gralco/PLS8-M.2-Key-B-3042/PLS8_M2_Key_B_3042.kicad_pcb

## KiCad design PLS8_M2_Key_B_3042.kicad_pcb (2022-02-09)

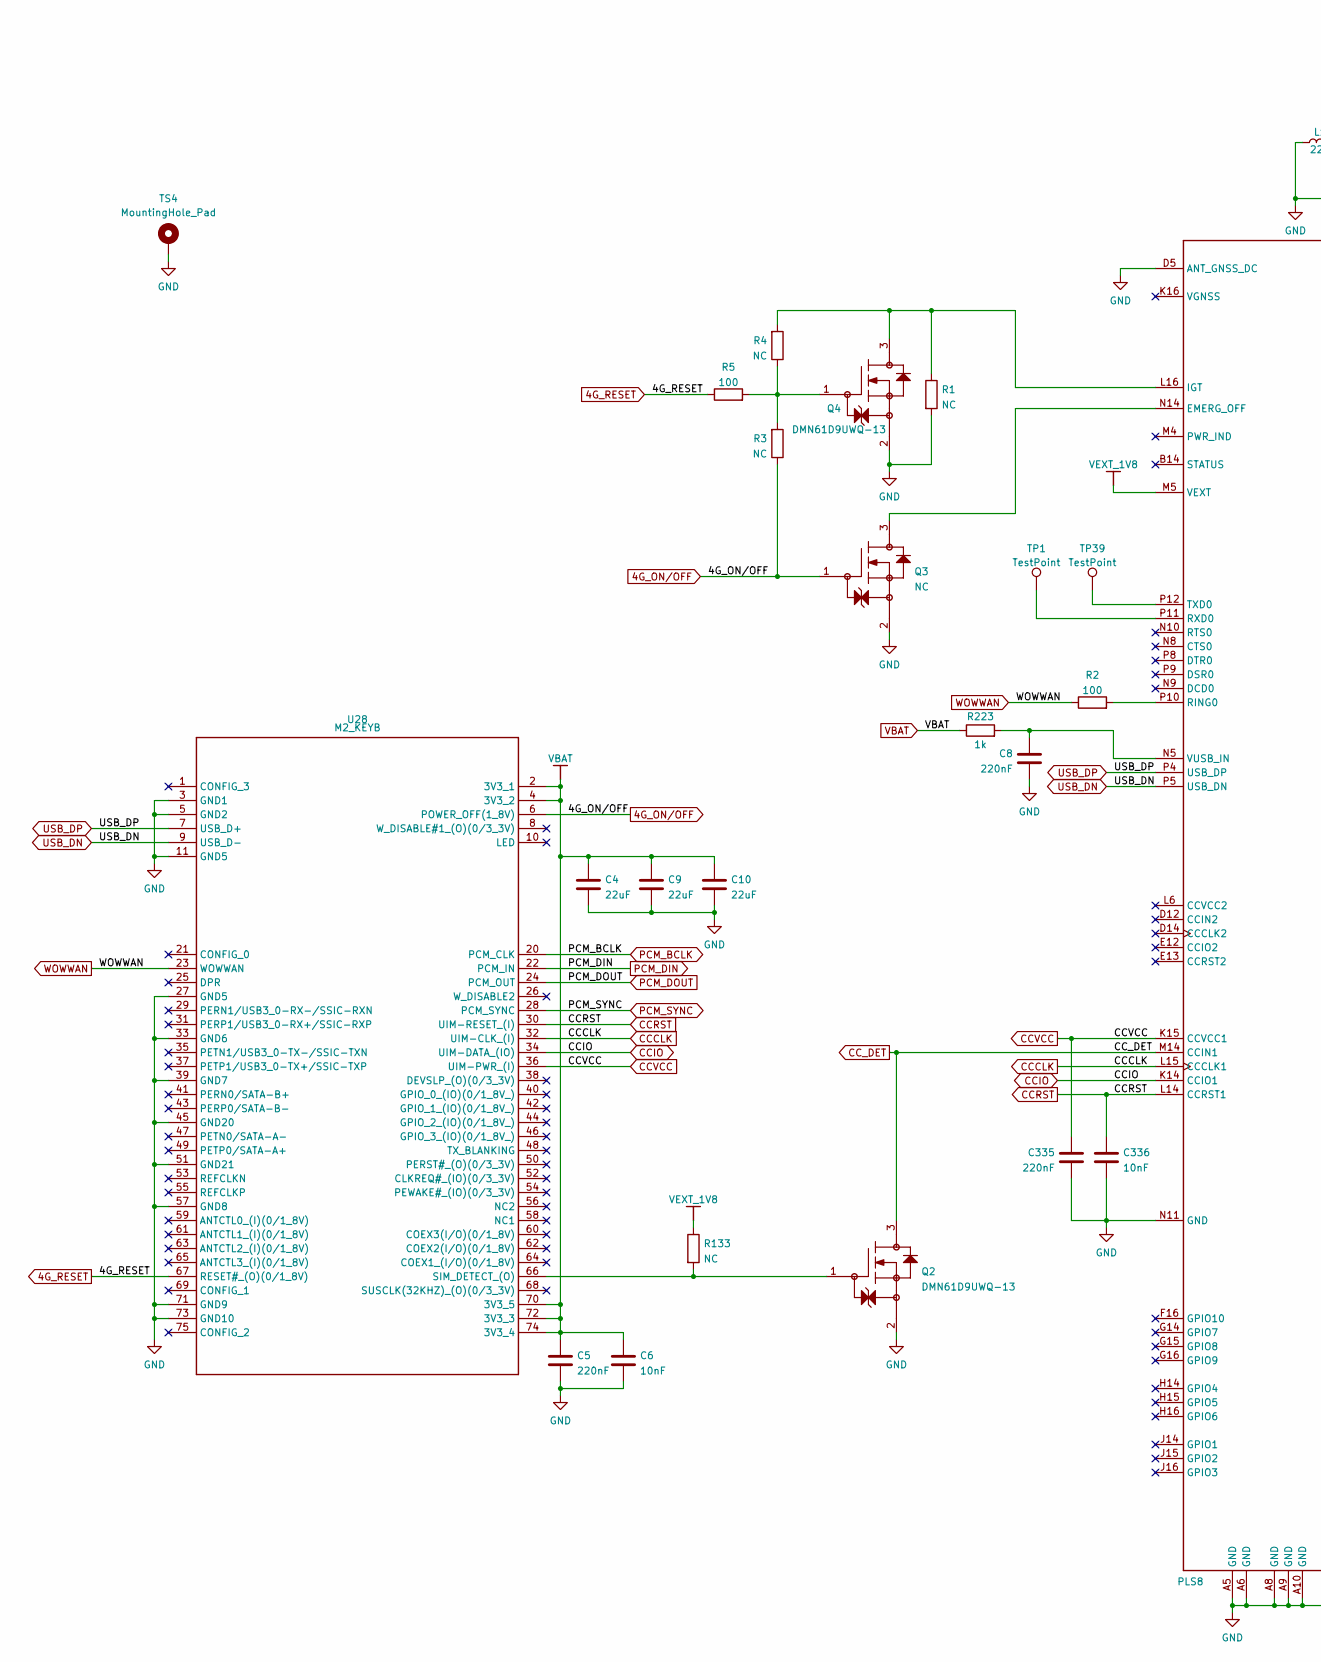
[picture p1: schematic PLS8_M2_Key_B_3042.kicad_sch, PLS8 M.2 Key B 3042 WWAN Module, part in row 1, column 1]

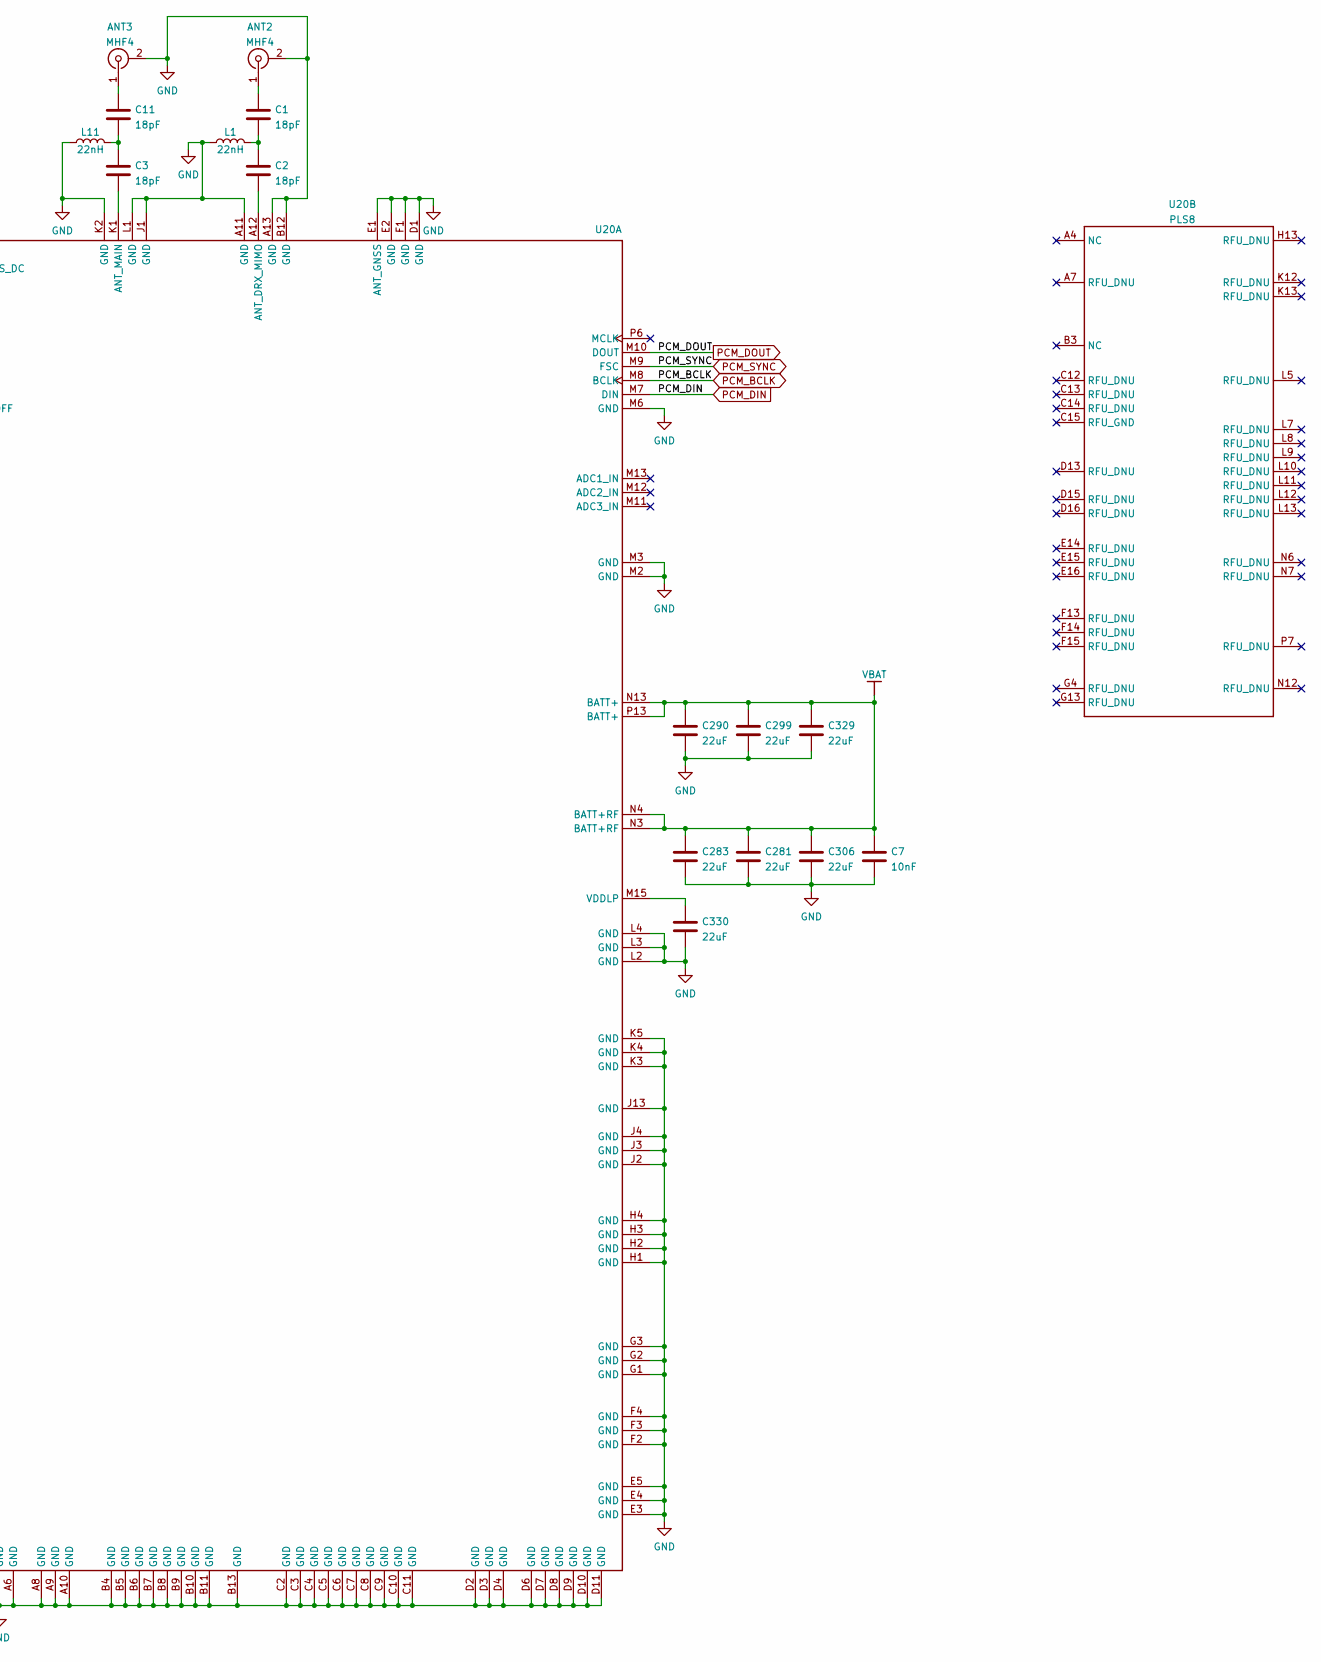
[picture p2: schematic PLS8_M2_Key_B_3042.kicad_sch, PLS8 M.2 Key B 3042 WWAN Module, part in row 1, column 2]

Parts:
ANT2, ANT3: MHF4; MHF4_20449-001E; MFG Part Num RECE-20449-001E-01
C1, C2, C3, C11: 18pF; C_0402_1005Metric; Tolerance 5%; MFG Part Num 0402N180J250CT
C4, C9, C10, C281, C283, C290, C299, C306, C329, C330: 22uF; C_0603_1608Metric; Tolerance 20%; MFG Part Num CL10A226MP8NUNE
C5, C8, C335: 220nF; C_0402_1005Metric; Tolerance 10%; MFG Part Num UMK105B7222KV-F
C6, C7, C336: 10nF; C_0402_1005Metric; Tolerance 10%; MFG Part Num CL05B103KB5NNNC
L1, L11: 22nH; L_0402_1005Metric; Tolerance 5%; MFG Part Num LQW15AN22NJ8ZD
Q2, Q4: DMN61D9UWQ-13; SOT-323_SC-70; MFG Part Num DMN61D9UWQ-13
Q3: NC; SOT-323_SC-70; MFG Part Num DMN61D9UWQ-13
R1, R3, R4: NC; R_0402_1005Metric; Tolerance 1%; MFG Part Num RC0402FR-07100RL
R2, R5: 100; R_0402_1005Metric; Tolerance 1%; MFG Part Num RC0402FR-07100RL
R133: NC; R_0402_1005Metric; Tolerance 1%; MFG Part Num RC0402FR-0747RL
R223: 1k; R_0402_1005Metric; Tolerance 1%; MFG Part Num RMCF0402FT1K00
TP1, TP39: TestPoint; TEST_POINT
TS4: MountingHole_Pad; M.2_Mounting_Hole
U20: PLS8; MFG Part Num PLS8-US Rel.4
U28: M2_KEYB; M2_KEYB_3042

Connections:
4G_ON/OFF: Q3.1 (GATE), R3.1, U28.6 (POWER_OFF(1_8V))
4G_RESET: R5.1, U28.67 (RESET#_(O)(0/1_8V))
CCCLK: U20.L15 (CCCLK1), U28.32 (UIM-CLK_(I))
CCIO: U20.K14 (CCIO1), U28.34 (UIM-DATA_(IO))
CCRST: C336.1, U20.L14 (CCRST1), U28.30 (UIM-RESET_(I))
CCVCC: C335.2, U20.K15 (CCVCC1), U28.36 (UIM-PWR_(I))
CC_DET: Q2.3 (S), U20.M14 (CCIN1)
GND: ANT2.2 (Ext), ANT3.2 (Ext), C4.2, C5.2, C6.2, C7.2, C8.2, C9.2, C10.2, C281.2, C283.2, C290.2, C299.2, C306.2, C329.2, C330.2, C335.1, C336.2, L1.1, L11.1, Q2.2 (D), Q3.2 (D), Q4.2 (D), R1.2, TS4.1, U20.A5 (GND), U20.A6 (GND), U20.A8 (GND), U20.A9 (GND), U20.A10 (GND), U20.A11 (GND), U20.A13 (GND), U20.B4 (GND), U20.B5 (GND), U20.B6 (GND), U20.B7 (GND), U20.B8 (GND), U20.B9 (GND), U20.B10 (GND), U20.B11 (GND), U20.B12 (GND), U20.B13 (GND), U20.C2 (GND), U20.C3 (GND), U20.C4 (GND), U20.C5 (GND), U20.C6 (GND), U20.C7 (GND), U20.C8 (GND), U20.C9 (GND), U20.C10 (GND), U20.C11 (GND), U20.D1 (GND), U20.D2 (GND), U20.D3 (GND), U20.D4 (GND), U20.D5 (ANT_GNSS_DC), U20.D6 (GND), U20.D7 (GND), U20.D8 (GND), U20.D9 (GND), U20.D10 (GND), U20.D11 (GND), U20.E1 (ANT_GNSS), U20.E2 (GND), U20.E3 (GND), U20.E4 (GND), U20.E5 (GND), U20.F1 (GND), U20.F2 (GND), U20.F3 (GND), U20.F4 (GND), U20.G1 (GND), U20.G2 (GND), U20.G3 (GND), U20.H1 (GND), U20.H2 (GND), U20.H3 (GND), U20.H4 (GND), U20.J1 (GND), U20.J2 (GND), U20.J3 (GND), U20.J4 (GND), U20.J13 (GND), U20.K2 (GND), U20.K3 (GND), U20.K4 (GND), U20.K5 (GND), U20.L1 (GND), U20.L2 (GND), U20.L3 (GND), U20.L4 (GND), U20.M2 (GND), U20.M3 (GND), U20.M6 (GND), U20.N11 (GND), U28.3 (GND1), U28.5 (GND2), U28.11 (GND5), U28.27 (GND5), U28.33 (GND6), U28.39 (GND7), U28.45 (GND20), U28.51 (GND21), U28.57 (GND8), U28.71 (GND9), U28.73 (GND10)
unnamed: ANT2.1 (In), C1.1
unnamed: ANT3.1 (In), C11.1
unnamed: C1.2, C2.1, L1.2
unnamed: C2.2, U20.A12 (ANT_DRX_MIMO)
unnamed: C3.2, U20.K1 (ANT_MAIN)
unnamed: C8.1, R223.2, U20.N5 (VUSB_IN)
unnamed: C3.1, C11.2, L11.2
unnamed: C330.1, U20.M15 (VDDLP)
unnamed: Q2.1 (GATE), R133.2, U28.66 (SIM_DETECT_(O))
unnamed: Q3.3 (S), U20.N14 (EMERG_OFF)
unnamed: Q4.1 (GATE), R3.2, R4.1, R5.2
unnamed: Q4.3 (S), R1.1, R4.2, U20.L16 (IGT)
unnamed: R2.2, U20.P10 (RING0)
unnamed: TP1.1, U20.P11 (RXD0)
unnamed: TP39.1, U20.P12 (TXD0)
PCM_BCLK: U20.M8 (BCLK), U28.20 (PCM_CLK)
PCM_DIN: U20.M7 (DIN), U28.22 (PCM_IN)
PCM_DOUT: U20.M10 (DOUT), U28.24 (PCM_OUT)
PCM_SYNC: U20.M9 (FSC), U28.28 (PCM_SYNC)
USB_DN: U20.P5 (USB_DN), U28.9 (USB_D-)
USB_DP: U20.P4 (USB_DP), U28.7 (USB_D+)
VBAT: C4.1, C5.1, C6.1, C7.1, C9.1, C10.1, C281.1, C283.1, C290.1, C299.1, C306.1, C329.1, R223.1, U20.N3 (BATT+RF), U20.N4 (BATT+RF), U20.N13 (BATT+), U20.P13 (BATT+), U28.2 (3V3_1), U28.4 (3V3_2), U28.70 (3V3_5), U28.72 (3V3_3), U28.74 (3V3_4)
VEXT_1V8: R133.1, U20.M5 (VEXT)
WOWWAN: R2.1, U28.23 (WOWWAN)

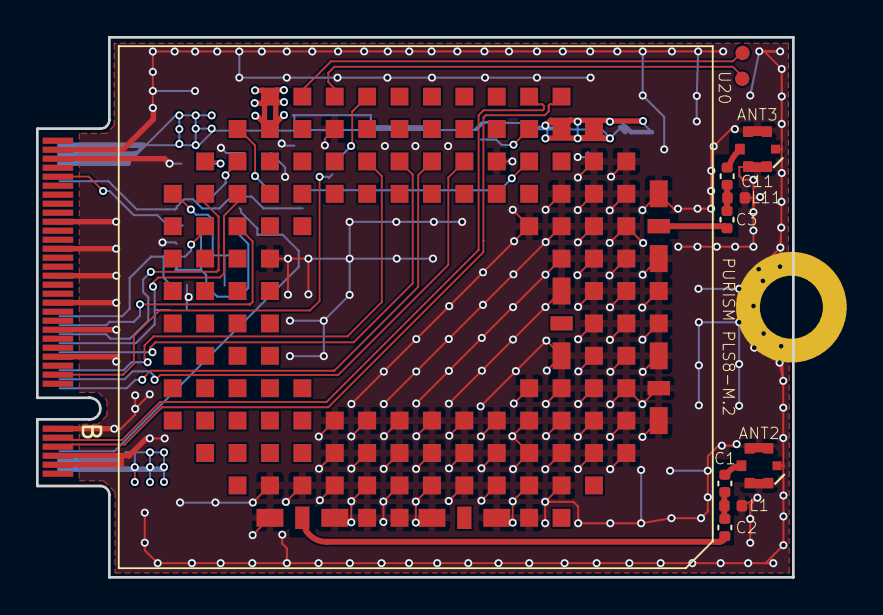
[picture p3: board PLS8_M2_Key_B_3042.kicad_pcb from above]

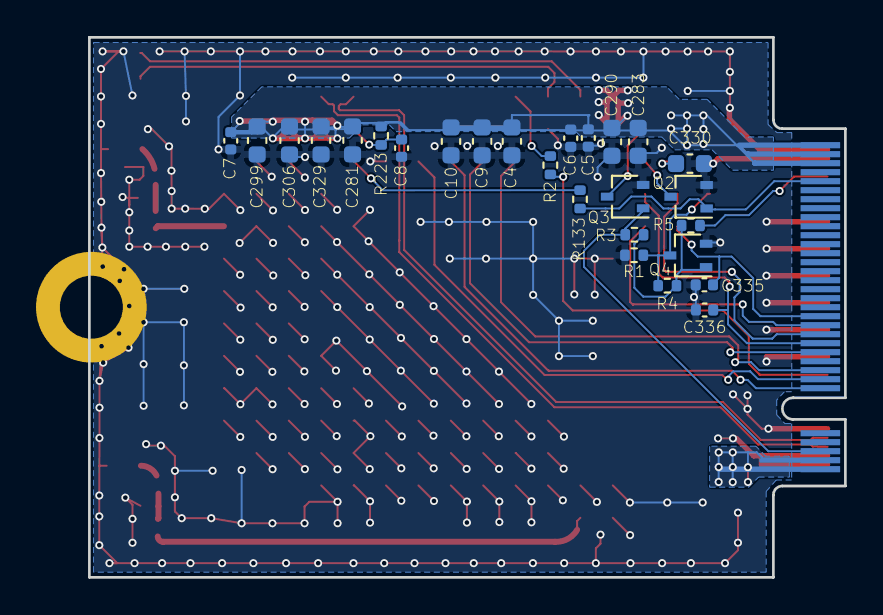
[picture p4: board PLS8_M2_Key_B_3042.kicad_pcb from below]

Board: 4 copper layers, 42.0 x 30.0 mm, 39 parts (26 on the bottom side), 32 nets.
