gralco/PLS8-M.2-Key-B-3042/(commit log)

2021-11-24 Add all of the imported files
    [PLS8_M2_Key_B_3042.kicad_pcb, PLS8_M2_Key_B_3042.kicad_sch]
2022-02-04 Use KiCad's built-in library for various symbols and footprints
    Make general improvements to the legibility of the schematic.
    Reuse some of the footprints from the dvk-mx8m-bsb project and others.
    Redefine all pins which were left as "passive" to being their
    corresponding functional definition.
    Make sure the schematic is passing ERC (no errors or warnings).
    [PLS8_M2_Key_B_3042.kicad_sch]
2022-02-04 Update the footprints in the layout using the ones assigned in the previous commit
    Make C7 10nF as it was previously.
    Fix the copper pour settings to make sure all connections are properly
    made.
    Adjust ATN2 and ANT3's footprint to have an underlying pad which copper
    pour can connect to.
    [PLS8_M2_Key_B_3042.kicad_pcb, PLS8_M2_Key_B_3042.kicad_sch]
2022-02-07 Fix all of the DRC violations.
    Made exceptions for courtyard overlaps where the components have not
    moved. Some components have been moved slightly to accomidate a minimum
    5mil soldermask sliver (especially due to the slightly larger pad sizes
    given in KiCad's footprint library).
    All silkscreen related-warnings have been ignored. The silkscreen
    reference designator text still needs to be moved.
    [PLS8_M2_Key_B_3042.kicad_pcb]
2022-02-09 Fix up the silkscreen and use a board stackup that has a thickness of 0.8mm
    [PLS8_M2_Key_B_3042.kicad_pcb]
