gralco/PLS8-M.2-Key-B-3042/(notices)

Notices in the files:
PLS8_M2_Key_B_3042.kicad_sch:
Copyright 2022 GNU GPLv3+
